kosma/gigabit-window-flex/production/bom.csv

Designator | Footprint | Quantity | Value | LCSC Part #
J1, J2 | RJ45_OST_PJ012-8P8CX_Vertical | 2 | MTJ-885X1
