kosma/gigabit-window-flex/gigabit-window-flex.kicad_sch

## KiCad design gigabit-window-flex.kicad_sch (2024-06-21)

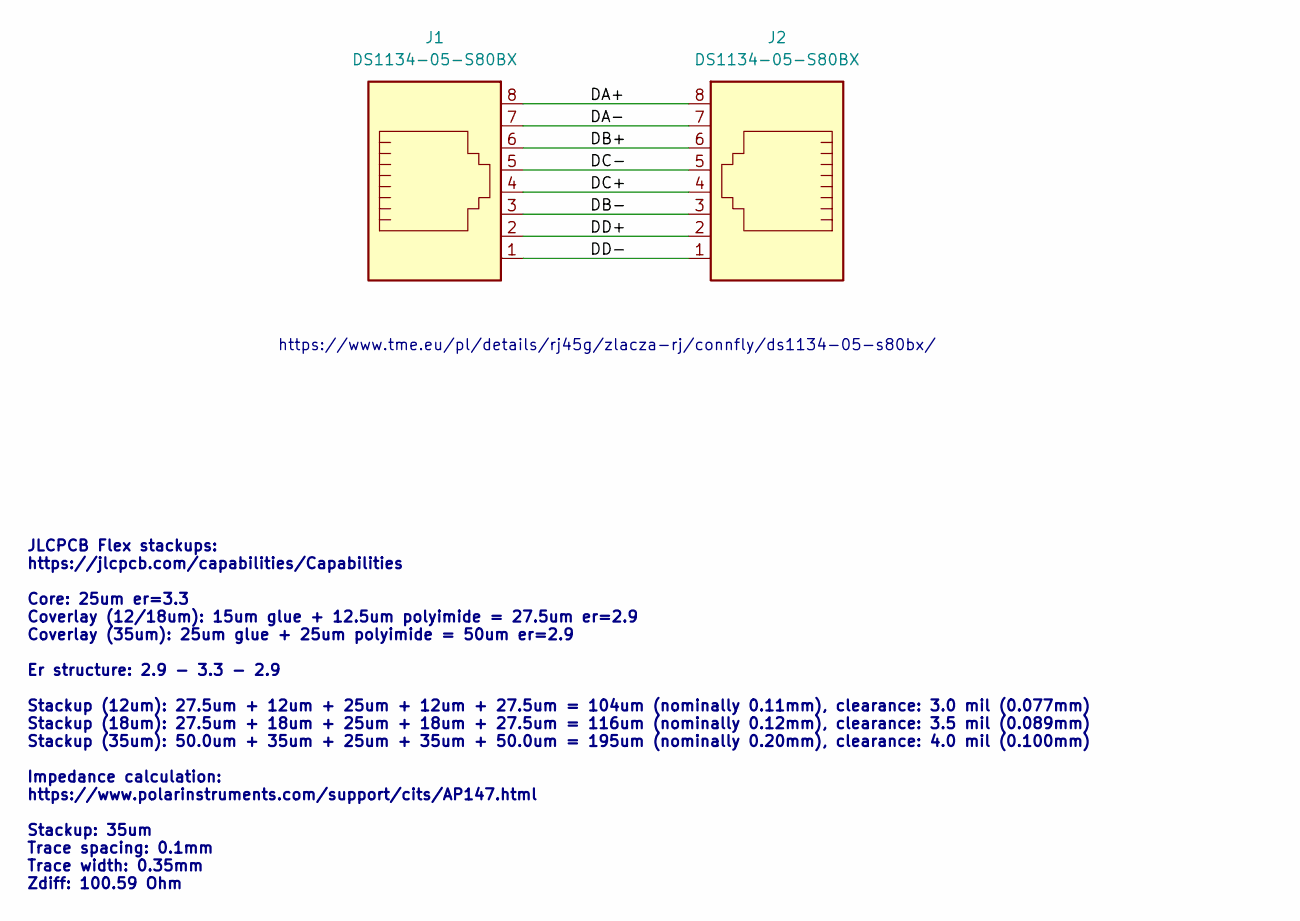
[picture p5: schematic gigabit-window-flex.kicad_sch]

Parts:
J1, J2: DS1134-05-S80BX; RJ45_OST_PJ012-8P8CX_Vertical

Connections:
DA+: J1.8, J2.8
DA-: J1.7, J2.7
DB+: J1.6, J2.6
DB-: J1.3, J2.3
DC+: J1.4, J2.4
DC-: J1.5, J2.5
DD+: J1.2, J2.2
DD-: J1.1, J2.1

Notes on the sheet:
JLCPCB Flex stackups: https://jlcpcb.com/capabilities/Capabilities Core: 25um er=3.3 Coverlay (12/18um): 15um glue + 12.5um polyimide = 27.5um er=2.9 Coverlay (35um): 25um glue + 25um polyimide = 50um er=2.9 Er structure: 2.9 - 3.3 - 2.9 Stackup (12um): 27.5um + 12um + 25um + 12um + 27.5um = 104um 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
https://www.tme.eu/pl/details/rj45g/zlacza-rj/connfly/ds1134-05-s80bx/
